Dinameo/wireless_audience_response_system/NRF52840_Quiz_Remote_BOM.xlsx

Sheet: Tổng quan
Số bo PCB cần làm | 1 | Hao hụt mặc định | 0%
Footprint trên PCB |  | 32
Linh kiện theo PCB / bo |  | 28
Số nhóm linh kiện |  | 9
Lỗ M3 (không phải linh kiện mua) |  | 4
Dòng BOM PCB chưa nhập đơn giá |  | 9
Dòng vật tư thêm bắt buộc chưa có giá |  | 1
Dự toán chi phí linh kiện / toàn bộ PCB |  | CHƯA ĐỦ GIÁ
Dự toán đầy đủ (PCB + vật tư có chọn mua) |  | CHƯA ĐỦ GIÁ
Phạm vi
BOM_PCB: 9 nhóm / 28 vị trí linh kiện đúng theo 2 file KiCad.
VAT_TU_THEM: module nRF52840, đặt gia công PCB, cọc/chân header và bộ vít nếu sử dụng.
CHI_TIET_PCB: đối chiếu đủ 32 footprint, gồm 4 lỗ M3 chỉ thuộc PCB.
Các ô chữ xanh là ô được phép điền: số PCB, hao hụt, giá, mã SKU, nhà bán và tùy chọn mua.
Nhập đơn giá thực tế (VND) trong BOM_PCB và VAT_TU_THEM để tính chi phí; không tự đặt giá tham khảo.
Chỉ mua pin CR2032-HFN có chân hàn đúng footprint, trừ khi đổi thiết kế BT1.

Sheet: BOM PCB
BOM LINH KIỆN GẮN TRÊN PCB
28 vị trí linh kiện điện tử, 9 nhóm vật tư. Giá trị & footprint theo project, giá/SKU là ô nhập tay.
STT | Reference | Tên linh kiện | Giá trị / model | Footprint trong PCB | Mặt PCB | SL / 1 bo | Số bo | Dự phòng % | SL cần mua | ĐVT | Đơn giá (VND) | Thành tiền (VND) | Mã đặt hàng / MPN | Nhà cung cấp | URL sản phẩm | Trạng thái | Ghi chú / điều cần xác nhận
1 | R1, R2, R3, R4, R5 | Điện trở chân cắm | 10 kΩ | Resistor_THT:R_Axial_DIN0207_L6.3mm_D2.5mm_P7.62mm_Horizontal | Mặt trước (F.Cu) | 5 | 1 | 0% | 5 | cái |  |  |  |  |  | CHƯA CÓ SKU | 1/4W thông dụng; thân gần 6,3×2,5 mm; bước chân 7,62 mm. Dung sai và hãng chưa được chỉ định. Cần chốt dung sai/nhà cung cấp.
2 | R6, R7, R8 | Điện trở hạn dòng LED | 330 Ω | Resistor_THT:R_Axial_DIN0207_L6.3mm_D2.5mm_P7.62mm_Horizontal | Mặt trước (F.Cu) | 3 | 1 | 0% | 3 | cái |  |  |  |  |  | CHƯA CÓ SKU | 1/4W thông dụng; thân gần 6,3×2,5 mm; bước chân 7,62 mm. Kiểm tra dòng LED theo màu/điện áp thực tế.
3 | C1, C2 | Tụ phân cực chân cắm | 10 µF | Capacitor_THT:CP_Radial_D4.0mm_P2.00mm | Mặt trước (F.Cu) | 2 | 1 | 0% | 2 | cái |  |  |  |  |  | CẦN XÁC NHẬN | D4,0 mm, P2,0 mm; điện áp định mức/chều cao chưa xác định trong schematic. Ưu tiên điện áp định mức phù hợp và kiểm tra cực tính.
4 | C3, C4, C5, C6, C7 | Tụ phân cực chân cắm | 1 µF | Capacitor_THT:CP_Radial_D5.0mm_P2.00mm | Mặt trước (F.Cu) | 5 | 1 | 0% | 5 | cái |  |  |  |  |  | CẦN XÁC NHẬN | D5,0 mm, P2,0 mm; điện áp định mức/chều cao chưa xác định trong schematic. Tụ phân cực trong mạch nút nhấn: phải kiểm tra điện áp hai đầu và chiều lắp.
5 | D1, D2, D3 | LED chân cắm 5 mm | LED D5.0 | LED_THT:LED_D5.0mm | Mặt trước (F.Cu) | 3 | 1 | 0% | 3 | cái |  |  |  |  |  | CẦN XÁC NHẬN | Màu sắc, Vf, If và mã linh kiện chưa được khai báo. Chốt màu LED và hướng A/K theo ký hiệu PCB.
6 | SW1, SW2, SW3, SW4, SW5, SW7 | Nút nhấn THT 6×6 mm | Tactile, H4.3 | Button_Switch_THT:SW_PUSH_6mm_H4.3mm | Mặt trước (F.Cu) | 6 | 1 | 0% | 6 | cái |  |  |  |  |  | CẦN XÁC NHẬN | Nút nhấn 4 chân, chiều cao 4,3 mm theo tên footprint; xác nhận vị trí 4 chân. SW1-4: A-D; SW5: SUBMIT; SW7: RESET.
7 | SW6 | Công tắc gạt SPDT | SS12D10 | SW_SS12D10_SPDT:SS12D10_SPDT_v1 | Mặt trước (F.Cu) | 1 | 1 | 0% | 1 | cái |  |  |  |  |  | CẦN XÁC NHẬN | Footprint tùy biến v1; 3 chân tại x=-4,7 / 0 / +4,7 mm. BẮT BUỘC đo chân switch thực mua khớp footprint tùy biến.
8 | J1, J2 | Socket cái thẳng 1×13 | 2.54 mm, 13P | Connector_PinSocket_2.54mm:PinSocket_1x13_P2.54mm_Vertical | Mặt sau (B.Cu) | 2 | 1 | 0% | 2 | cái |  |  |  |  |  | CẦN XÁC NHẬN | Loại xuyên lỗ chân thẳng, 13 chân/hàng; cả hai đang ở B.Cu (mặt dưới). Kiểm tra module nRF52840 2×13 và hướng cắm; mua 2 thanh 13P.
9 | BT1 | Pin CR2032 có chân hàn | CR2032-HFN | Battery:Battery_Panasonic_CR2032-HFN_Horizontal_CircularHoles | Mặt trước (F.Cu) | 1 | 1 | 0% | 1 | cái |  |  |  |  |  | CẦN XÁC NHẬN | Footprint Panasonic CR2032-HFN nằm ngang, kiểu pin hàn trực tiếp (không phải đế pin tháo rời). Pin sơ cấp 3 V: KHÔNG sạc. Nếu muốn dùng đế pin thì phải sửa footprint PCB.
 |  | TỔNG LINH KIỆN GẮN PCB |  |  |  | 28 |  |  | 28 |  |  | 0 ₫

Sheet: Vật tư thêm
VẬT TƯ BỔ SUNG & PHỤ KIỆN LẮP RÁP
Không phải tất cả đều xuất hiện trong Schematic. Cột MUA? cho phép chỉ tính vật tư thật sự cần.
STT | Loại | Tên vật tư | Thông số cần mua / chọn | SL / 1 bo | Số bo | MUA? | SL cần mua | Đơn giá (VND) | Thành tiền (VND) | Nhà cung cấp | URL sản phẩm | Ghi chú mua hàng
2 | Bắt buộc | Bo mạch PCB gia công | FR-4 2 lớp, dày 1,6 mm; theo Gerber cuối cùng | 1 | 1 | Có | 1 |  |  |  |  | Chi phí sản xuất PCB, không phải linh kiện điện tử; thông số board thickness trong file PCB là 1,6 mm.
3 | Tùy kiện | Thanh header đực 1×13, P2.54 | 2 thanh 13 chân; chỉ cần nếu module nRF52840 chưa có chân hàn sẵn | 2 | 1 | Không | 0 |  |  |  |  | Không mua trùng nếu module đã gắn pin đực.
4 | Tùy kiện | Vít M3 | Bộ vít M3 theo chiều dày vỏ/spacer thực tế | 4 | 1 | Không | 0 |  |  |  |  | Lắp vào H1-H4, lỗ khoan 3,2 mm; cần chọn chiều dài thực tế.
5 | Tùy kiện | Đai ốc M3 | Đai ốc M3 (nếu không có ren âm / insert) | 4 | 1 | Không | 0 |  |  |  |  | Cân nhắc cơ cấu bắt vào vỏ.
6 | Tùy kiện | Long đền M3 | Đệm M3 nếu cần tránh tác động lên PCB | 4 | 1 | Không | 0 |  |  |  |  | Kiểm tra đường kính ngoài đệm không chạm đường đồng/linh kiện.
7 | Tùy kiện | Spacer M3 | Trụ cách M3, chiều cao theo vỏ/mặt bo | 4 | 1 | Không | 0 |  |  |  |  | Không chọn chiều cao cho đến khi có thiết kế vỏ.
8 | Tùy kiện | Vỏ / in 3D | Vỏ bảo vệ remote nRF52840, thiết kế theo kích thước PCB | 1 | 1 | Không | 0 |  |  |  |  | Không có bản vẽ cơ khí vỏ trong dự án KiCad hiện tại.
 |  | TỔNG VẬT TƯ CHỌN MUA |  |  |  |  | 1 |  | 0 ₫

Sheet: Chi tiết PCB
DANH SÁCH 32 FOOTPRINT - ĐỐI CHIẾU
Nguồn dữ liệu: file .kicad_pcb đối chiếu .kicad_sch. H1-H4: board-only, không đếm làm linh kiện mua.
Reference | Giá trị (Sch) | Giá trị (PCB) | KiCad symbol | Footprint (trong PCB) | Pads | Mặt PCB | Có trong Schematic? | Là linh kiện BOM? | Giá trị / FP trùng Sch? | Ghi chú
BT1 | Battery_Cell | Battery_Cell | Device:Battery_Cell | Battery:Battery_Panasonic_CR2032-HFN_Horizontal_CircularHoles | 2 | F.Cu | Có | Có | Khớp | CR2032-HFN hàn trực tiếp, không phải đế pin.
C1 | 10uF | 10uF | Device:C_Polarized | Capacitor_THT:CP_Radial_D4.0mm_P2.00mm | 2 | F.Cu | Có | Có | Khớp
C2 | 10uF | 10uF | Device:C_Polarized | Capacitor_THT:CP_Radial_D4.0mm_P2.00mm | 2 | F.Cu | Có | Có | Khớp
C3 | 1uF | 1uF | Device:C_Polarized | Capacitor_THT:CP_Radial_D5.0mm_P2.00mm | 2 | F.Cu | Có | Có | Khớp
C4 | 1uF | 1uF | Device:C_Polarized | Capacitor_THT:CP_Radial_D5.0mm_P2.00mm | 2 | F.Cu | Có | Có | Khớp
C5 | 1uF | 1uF | Device:C_Polarized | Capacitor_THT:CP_Radial_D5.0mm_P2.00mm | 2 | F.Cu | Có | Có | Khớp
C6 | 1uF | 1uF | Device:C_Polarized | Capacitor_THT:CP_Radial_D5.0mm_P2.00mm | 2 | F.Cu | Có | Có | Khớp
C7 | 1uF | 1uF | Device:C_Polarized | Capacitor_THT:CP_Radial_D5.0mm_P2.00mm | 2 | F.Cu | Có | Có | Khớp
D1 | LED | LED | Device:LED | LED_THT:LED_D5.0mm | 2 | F.Cu | Có | Có | Khớp
D2 | LED | LED | Device:LED | LED_THT:LED_D5.0mm | 2 | F.Cu | Có | Có | Khớp
D3 | LED | LED | Device:LED | LED_THT:LED_D5.0mm | 2 | F.Cu | Có | Có | Khớp
H1 |  | MountingHole_3.2mm_M3 | (PCB only) | MountingHole:MountingHole_3.2mm_M3 | 1 | F.Cu | Không | Không | Chỉ có trên PCB | Lỗ cơ khí 3,2 mm cho vít M3; không cần mua footprint. Board-only / exclude_from_bom.
H2 |  | MountingHole_3.2mm_M3 | (PCB only) | MountingHole:MountingHole_3.2mm_M3 | 1 | F.Cu | Không | Không | Chỉ có trên PCB | Lỗ cơ khí 3,2 mm cho vít M3; không cần mua footprint. Board-only / exclude_from_bom.
H3 |  | MountingHole_3.2mm_M3 | (PCB only) | MountingHole:MountingHole_3.2mm_M3 | 1 | F.Cu | Không | Không | Chỉ có trên PCB | Lỗ cơ khí 3,2 mm cho vít M3; không cần mua footprint. Board-only / exclude_from_bom.
H4 |  | MountingHole_3.2mm_M3 | (PCB only) | MountingHole:MountingHole_3.2mm_M3 | 1 | F.Cu | Không | Không | Chỉ có trên PCB | Lỗ cơ khí 3,2 mm cho vít M3; không cần mua footprint. Board-only / exclude_from_bom.
J1 | NRF_LEFT | NRF_LEFT | Connector:Conn_01x13_Socket | Connector_PinSocket_2.54mm:PinSocket_1x13_P2.54mm_Vertical | 13 | B.Cu | Có | Có | Khớp | Socket được đặt ở mặt B.Cu; kiểm tra hướng lắp.
J2 | NRF_RIGHT | NRF_RIGHT | Connector:Conn_01x13_Socket | Connector_PinSocket_2.54mm:PinSocket_1x13_P2.54mm_Vertical | 13 | B.Cu | Có | Có | Khớp | Socket được đặt ở mặt B.Cu; kiểm tra hướng lắp.
R1 | 10k | 10k | Device:R | Resistor_THT:R_Axial_DIN0207_L6.3mm_D2.5mm_P7.62mm_Horizontal | 2 | F.Cu | Có | Có | Khớp
R2 | 10k | 10k | Device:R | Resistor_THT:R_Axial_DIN0207_L6.3mm_D2.5mm_P7.62mm_Horizontal | 2 | F.Cu | Có | Có | Khớp
R3 | 10k | 10k | Device:R | Resistor_THT:R_Axial_DIN0207_L6.3mm_D2.5mm_P7.62mm_Horizontal | 2 | F.Cu | Có | Có | Khớp
R4 | 10k | 10k | Device:R | Resistor_THT:R_Axial_DIN0207_L6.3mm_D2.5mm_P7.62mm_Horizontal | 2 | F.Cu | Có | Có | Khớp
R5 | 10k | 10k | Device:R | Resistor_THT:R_Axial_DIN0207_L6.3mm_D2.5mm_P7.62mm_Horizontal | 2 | F.Cu | Có | Có | Khớp
R6 | 330 | 330 | Device:R | Resistor_THT:R_Axial_DIN0207_L6.3mm_D2.5mm_P7.62mm_Horizontal | 2 | F.Cu | Có | Có | Khớp
R7 | 330 | 330 | Device:R | Resistor_THT:R_Axial_DIN0207_L6.3mm_D2.5mm_P7.62mm_Horizontal | 2 | F.Cu | Có | Có | Khớp
R8 | 330 | 330 | Device:R | Resistor_THT:R_Axial_DIN0207_L6.3mm_D2.5mm_P7.62mm_Horizontal | 2 | F.Cu | Có | Có | Khớp
SW1 | ANSWER_A | ANSWER_A | Switch:SW_Push | Button_Switch_THT:SW_PUSH_6mm_H4.3mm | 4 | F.Cu | Có | Có | Khớp
SW2 | ANSWER_B | ANSWER_B | Switch:SW_Push | Button_Switch_THT:SW_PUSH_6mm_H4.3mm | 4 | F.Cu | Có | Có | Khớp
SW3 | ANSWER_C | ANSWER_C | Switch:SW_Push | Button_Switch_THT:SW_PUSH_6mm_H4.3mm | 4 | F.Cu | Có | Có | Khớp
SW4 | ANSWER_D | ANSWER_D | Switch:SW_Push | Button_Switch_THT:SW_PUSH_6mm_H4.3mm | 4 | F.Cu | Có | Có | Khớp
SW5 | SUBMIT | SUBMIT | Switch:SW_Push | Button_Switch_THT:SW_PUSH_6mm_H4.3mm | 4 | F.Cu | Có | Có | Khớp
SW6 | POWER | POWER | Switch:SW_SPST | SW_SS12D10_SPDT:SS12D10_SPDT_v1 | 3 | F.Cu | Có | Có | Khớp | Công tắc footprint tùy biến; đo kích thước thật.
SW7 | RESET | RESET | Switch:SW_Push | Button_Switch_THT:SW_PUSH_6mm_H4.3mm | 4 | F.Cu | Có | Có | Khớp

Sheet: Lưu ý
CHECKLIST TRƯỚC KHI ĐẶT MUA
Những rủi ro có thể ảnh hưởng đến việc mua đúng hàng và lắp ráp được PCB.
Hạng mục | Thông tin phát hiện | Việc phải kiểm tra / thao tác | Mức độ | Nguồn
NGUỒN / PIN | BT1 đang dùng Battery:Battery_Panasonic_CR2032-HFN_Horizontal_CircularHoles. | Phải dùng pin CR2032 có tab chân hàn dạng HFN đúng bước chân/không gian; nếu thay bằng đế pin CR2032 thông thường cần sửa footprint và layout. | Rất quan trọng | https://gitlab.com/kicad/libraries/kicad-footprints/-/blob/master/Battery.pretty/Battery_Panasonic_CR2032-HFN_Horizontal_CircularHoles.kicad_mod
AN TOÀN PIN | CR2032 là pin lithium sơ cấp danh định 3 V, không thể sạc. | Kiểm tra đường mạch module và chân cấp nguồn thực tế; tuyệt đối không nối đường sạc vào pin CR2032. | Rất quan trọng | https://energy.panasonic.com/dam/master/pdf/en/datasheet/lithium/CR2032_Datasheet_EN_240701.pdf
MÓC NỐI / MODULE | J1 và J2 là hai socket 13 chân 2.54 mm, đặt trên B.Cu. | Đối chiếu sơ đồ chân, chiều rộng 2 hàng và mặt lắp nRF52840 SuperMini; chân đực module phải tương thích socket cái mặt dưới. | Rất quan trọng | https://kicad.github.io/footprints/Connector_PinSocket_2.54mm.html
CÔNG TẮC | SW6 có footprint tùy biến SW_SS12D10_SPDT:SS12D10_SPDT_v1. | Theo file .kicad_mod: 3 tâm chân ở x = -4,7; 0; +4,7 mm, 1mm drill. Không mua switch chỉ dựa tên SS12D10. | Rất quan trọng | Nguồn nội bộ: SW_SS12D10_SPDT.pretty/SS12D10_SPDT_v1.kicad_mod
TỤ PHÂN CỰC | C1-C7 đều dùng symbol Device:C_Polarized. | C1-C2: 10 µF, D4mm P2mm; C3-C7: 1 µF, D5mm P2mm. Chưa có điện áp định mức, chiều cao hay MPN. | Cần kiểm tra | Nguồn nội bộ: .kicad_sch và .kicad_pcb
TỤ CHỐNG DỘI | C3-C7 dùng tụ phân cực tại các mạch nút nhấn theo giá trị 1 µF. | Kiểm tra cực tính theo mức áp từng chân trong tất cả trạng thái, phù hợp thời gian debounce; tụ không phân cực có thể cần footprint khác. | Cần kiểm tra | Nguồn nội bộ: .kicad_sch
LED | D1-D3 chỉ khai báo giá trị LED, không ghi màu hoặc mã. | Chọn LED 5 mm cùng chân THT; xác nhận màu/độ sáng/Vf/If để kiểm tra điện trở 330 Ω. | Cần kiểm tra | Nguồn nội bộ: .kicad_sch
ĐIỆN TRỞ | R1-R5: 10 kΩ; R6-R8: 330 Ω; footprint DIN0207 L6.3×D2.5 P7.62. | Chọn linh kiện 1/4 W hoặc tương đương có kích thước thân/chân tương thích. Trị số chịu sai số chưa chỉ định. | Cần kiểm tra | Nguồn nội bộ: .kicad_pcb
NÚT NHẤN | SW1-SW5 và SW7 có footprint SW_PUSH_6mm_H4.3mm. | Mua nút nhấn THT 6×6 mm đúng vị trí 4 chân; kiểm tra chiều cao lộ ra khỏi vỏ. | Cần kiểm tra | Nguồn nội bộ: .kicad_pcb
LỖ CƠ KHÍ | H1-H4 là lỗ M3, pad 3,2 mm, thuộc tính board_only và exclude_from_bom. | Không mua một linh kiện tên H1. Mua ốc M3 và spacer chỉ khi cấu trúc vỏ yêu cầu; kiểm tra vùng trống quanh đầu vít. | Thông tin | Nguồn nội bộ: .kicad_pcb
BOM & DỮ LIỆU | Không có MPN/SKU, supplier, unit price và datasheet linh kiện cụ thể trong Schematic. | Vì thế file này để trống các trường mua hàng để tránh giả định sai. Sau khi chọn mẫu thật, lưu datasheet/link vào Excel. | Cần bổ sung | Nguồn nội bộ: .kicad_sch
DRC / ERC | BOM không chứng minh PCB đúng điện hoặc phù hợp để chế tạo. | Kiểm tra ERC, DRC, polarity, 3D cơ khí, output Gerber/drill; BOM chỉ xác minh số lượng và footprint. | Thông tin | Nguồn nội bộ: .kicad_pcb/.kicad_sch

Sheet: Nguồn dữ liệu
NGUỒN & PHƯƠNG PHÁP TRÍCH XUẤT
Thông tin | Giá trị / mô tả
Tên dự án | NRF52840_Quiz_Remote
Nguồn schematic | NRF52840_Quiz_Remote/NRF52840_Quiz_Remote.kicad_sch
Nguồn PCB | NRF52840_Quiz_Remote/NRF52840_Quiz_Remote.kicad_pcb
SHA256 schematic | 02c77d5245ab06772fbb29b13a0cc0347ea4944395376ec3a9d2d5b3516fb469
SHA256 PCB | bcae5cba2324009f77dd3607b17fb2695f55706239005fb1716ed6d1a14543d0
KiCad PCB version | 10.0 (ghi trong file PCB)
BOM PCB | Nhóm theo loại, trị số và footprint; 28 linh kiện, 9 dòng nhóm
Lỗ M3 | H1-H4: board only, excluded from standard BOM; nằm tại sheet CHI_TIET_PCB
Giá, MPN, NCC | Không có trong KiCad; được để trống để cập nhật theo báo giá thực tế
Module nRF52840 | Không có một footprint U1 rời trong PCB; được ghi thêm mục vật tư để có đủ vật liệu làm sản phẩm
THAM KHẢO
KiCad: footprint CR2032-HFN | https://gitlab.com/kicad/libraries/kicad-footprints/-/blob/master/Battery.pretty/Battery_Panasonic_CR2032-HFN_Horizontal_CircularHoles.kicad_mod
Panasonic: CR2032 datasheet | https://energy.panasonic.com/dam/master/pdf/en/datasheet/lithium/CR2032_Datasheet_EN_240701.pdf
KiCad: footprint socket 2.54mm | https://kicad.github.io/footprints/Connector_PinSocket_2.54mm.html
