Dinameo/wireless_audience_response_system/Case/Submit.SLDPRT

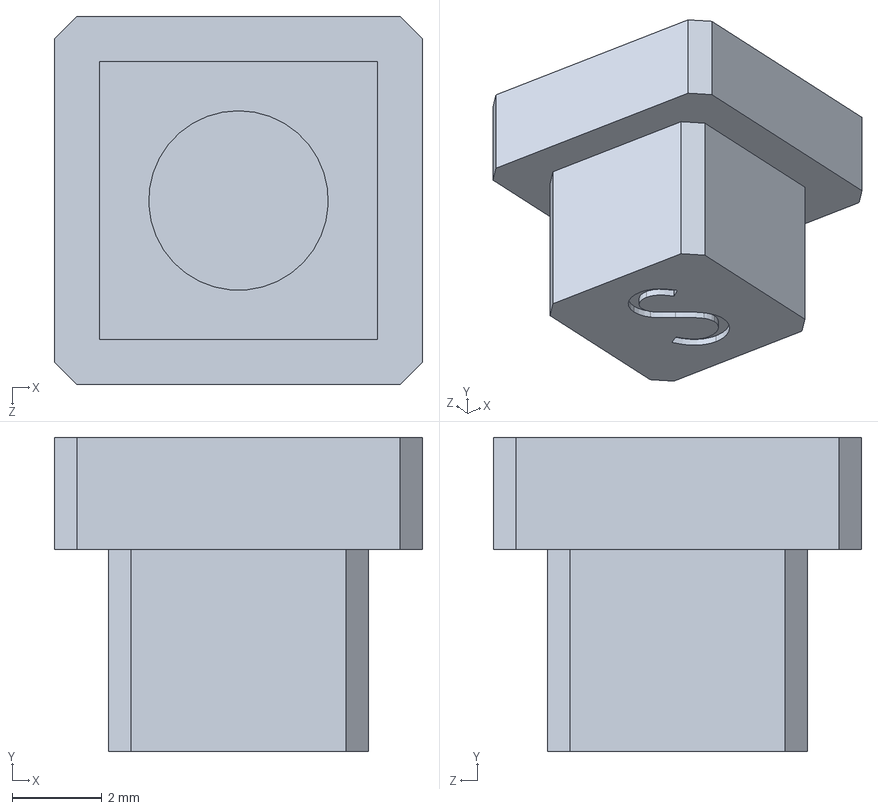
[picture p6: CAD file, 2026-10-14]
Case/Submit.SLDPRT
8.20 x 7.00 x 8.20 mm
