Dinameo/wireless_audience_response_system/Case/D_ans.SLDPRT

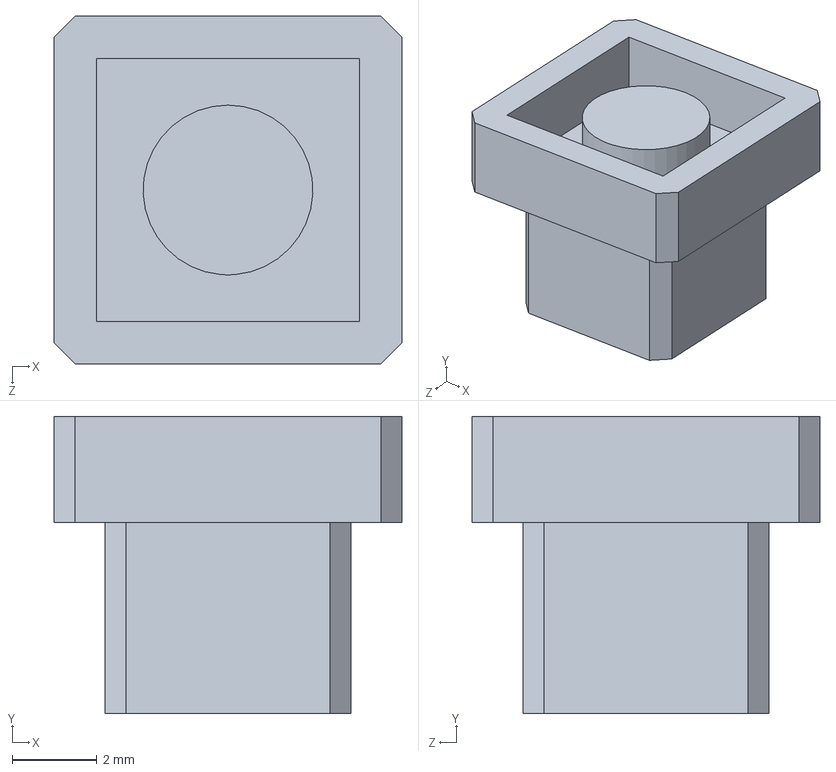
[picture p7: CAD file, 2026-10-14]
Case/D_ans.SLDPRT
8.20 x 7.00 x 8.20 mm
