Dinameo/wireless_audience_response_system/Case/Top.SLDPRT

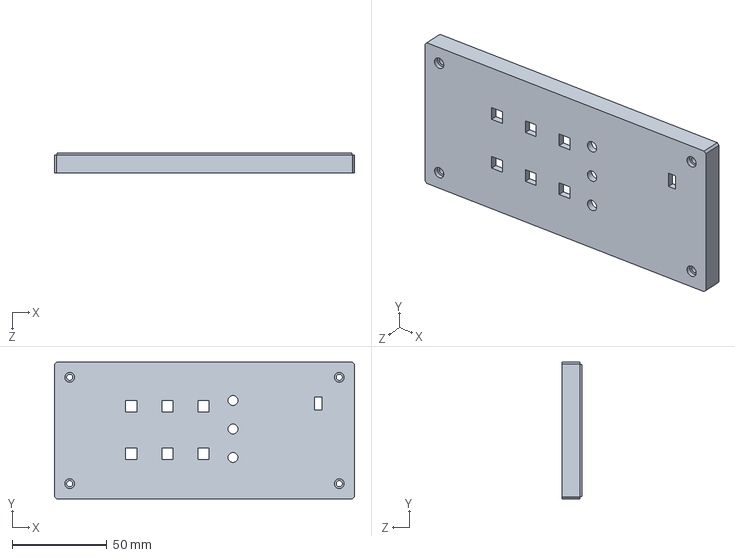
[picture p8: CAD file, 2026-10-14]
Case/Top.SLDPRT
158.0 x 72.0 x 10.5 mm
