Dinameo/wireless_audience_response_system/Case/Bottom.SLDPRT

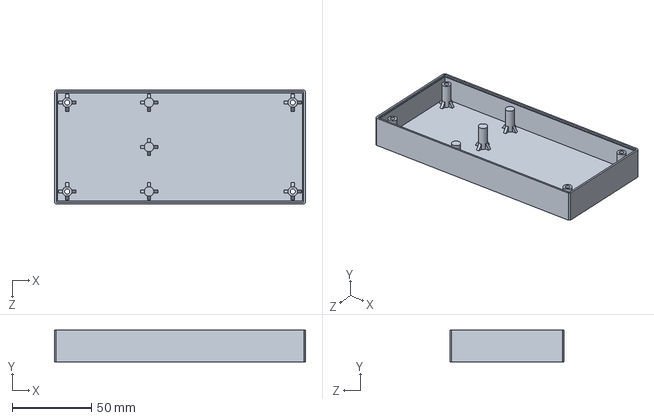
[picture p9: CAD file, 2026-10-14]
Case/Bottom.SLDPRT
158.0 x 20.0 x 72.0 mm
