Dinameo/wireless_audience_response_system/Case/Remote.SLDASM

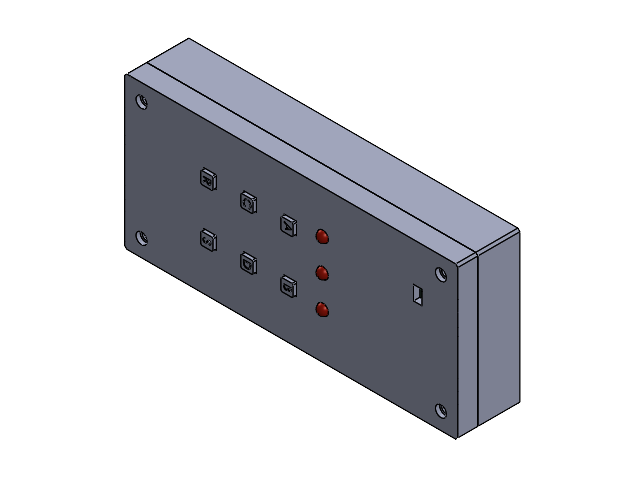
[picture p11: CAD file, 2026-10-14]
Case/Remote.SLDASM
Top
A_ans
Bottom
B_ans
C_ans
D_ans
Submit
Reset
R_Axial_DIN0207_L63mm_D25mm_P762mm_Horizontal.step x 8
LED_D5.0mm-0.step x 3
SW_PUSH_6mm_h4.3mm_1.step x 6
CP_Radial_D50mm_P200mm.step x 5
CP_Radial_D40mm_P200mm.step x 2
PinSocket_1x13_P2.54mm_Vertical-1.step x 2
NRF52840_Quiz_Remote_PCB.step
