Dinameo/wireless_audience_response_system/(list of files, cad)

Other CAD files:
Case/Reset.SLDPRT
Case/A_ans.SLDPRT
Case/B_ans.SLDPRT
Case/C_ans.SLDPRT
Case/A_ans.STL
Case/B_ans.STL
Case/Bottom.STL
Case/C_ans.STL
Case/D_ans.STL
Case/Reset.STL
Case/Submit.STL
Case/Top.STL
