Dinameo/wireless_audience_response_system/NRF52840_Quiz_Remote/NRF52840_Quiz_Remote.kicad_pcb

## KiCad design NRF52840_Quiz_Remote/NRF52840_Quiz_Remote.kicad_pcb (2026-10-14)

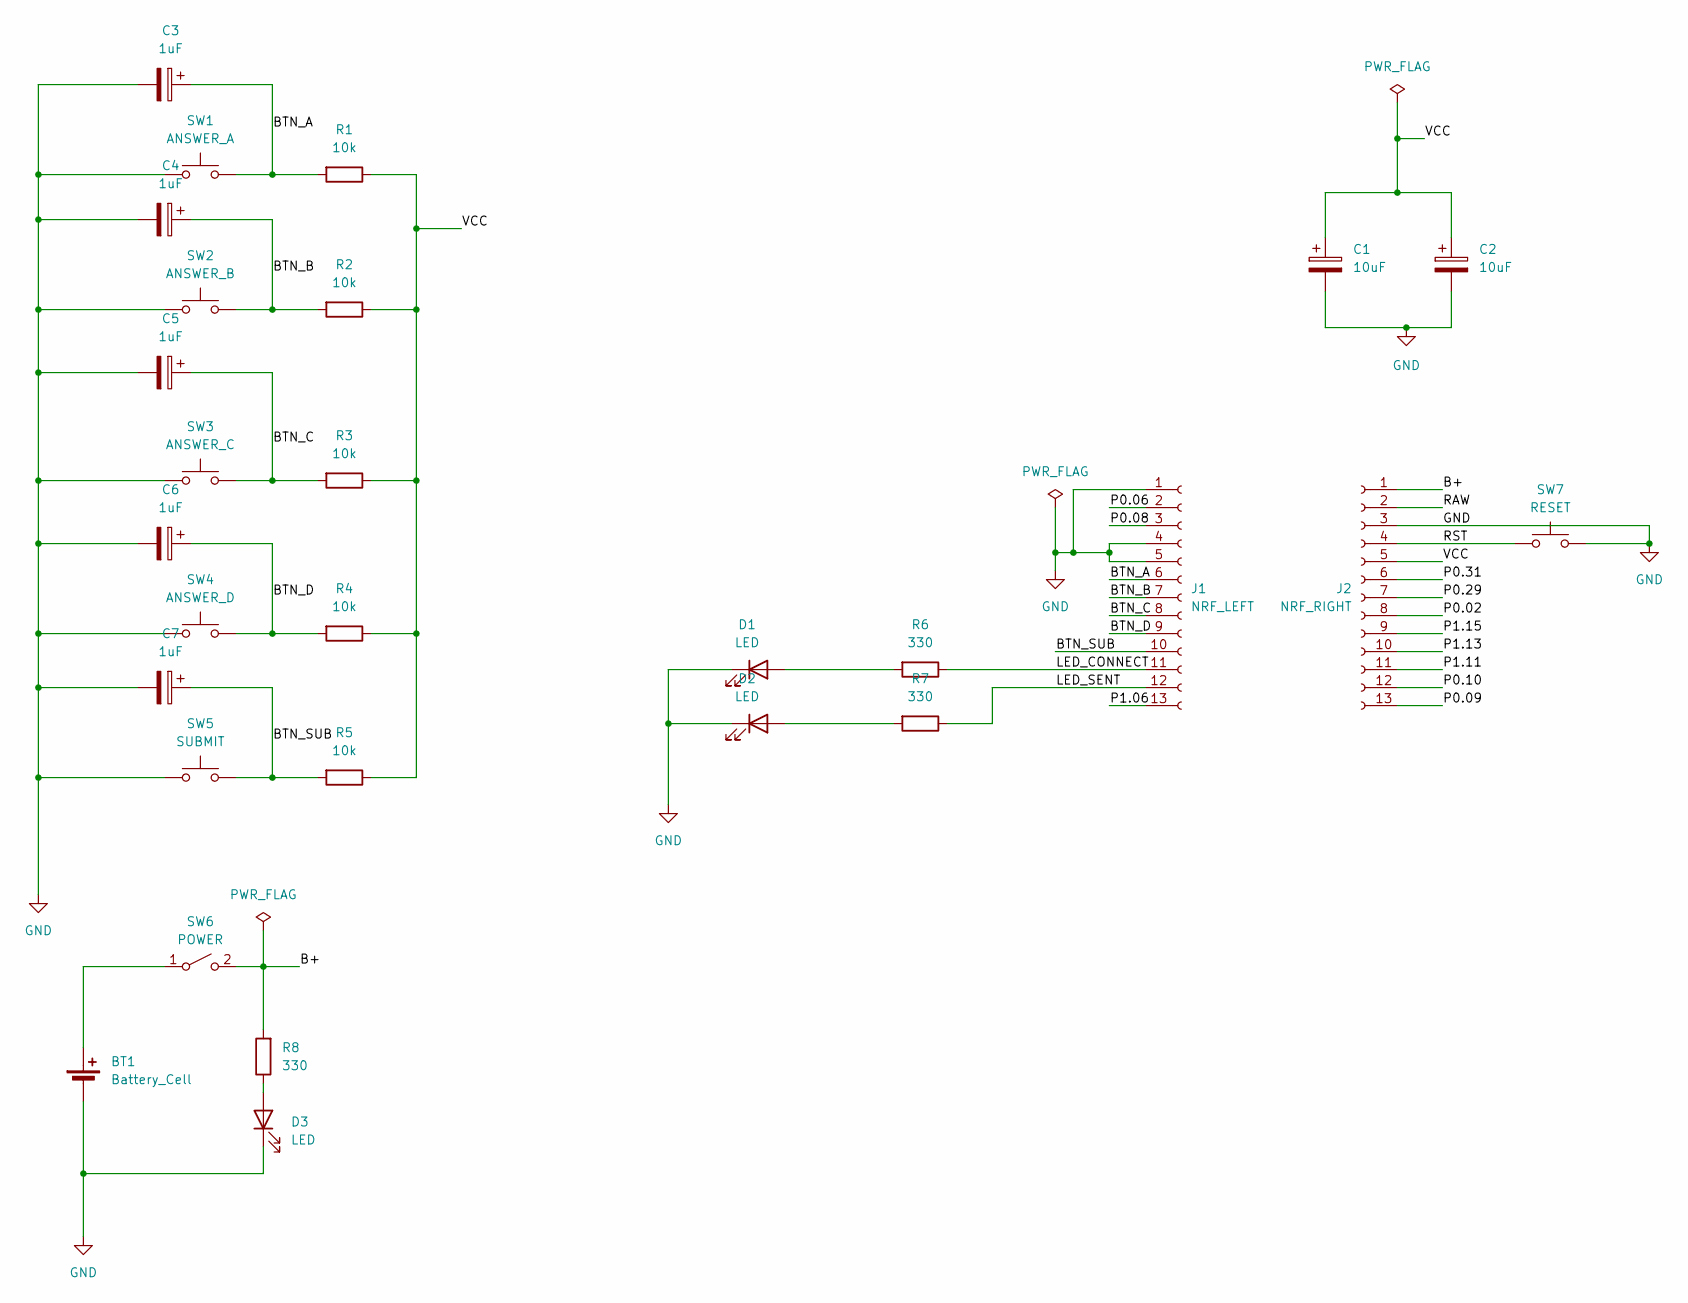
[picture p12: schematic NRF52840_Quiz_Remote.kicad_sch]

Parts:
BT1: Battery_Cell; Battery_Panasonic_CR2032-HFN_Horizontal_CircularHoles
C1, C2: 10uF; CP_Radial_D4.0mm_P2.00mm
C3, C4, C5, C6, C7: 1uF; CP_Radial_D5.0mm_P2.00mm
D1, D2, D3: LED; LED_D5.0mm
J1: NRF_LEFT; PinSocket_1x13_P2.54mm_Vertical
J2: NRF_RIGHT; PinSocket_1x13_P2.54mm_Vertical
R1, R2, R3, R4, R5: 10k; R_Axial_DIN0207_L6.3mm_D2.5mm_P7.62mm_Horizontal
R6, R7, R8: 330; R_Axial_DIN0207_L6.3mm_D2.5mm_P7.62mm_Horizontal
SW1: ANSWER_A; SW_PUSH_6mm_H4.3mm
SW2: ANSWER_B; SW_PUSH_6mm_H4.3mm
SW3: ANSWER_C; SW_PUSH_6mm_H4.3mm
SW4: ANSWER_D; SW_PUSH_6mm_H4.3mm
SW5: SUBMIT; SW_PUSH_6mm_H4.3mm
SW6: POWER; SS12D10_SPDT_v1
SW7: RESET; SW_PUSH_6mm_H4.3mm

Connections:
/B+: J2.1, R8.2, SW6.2 (B)
/BTN_A: C3.1, J1.6, R1.2, SW1.2
/BTN_B: C4.1, J1.7, R2.2, SW2.2
/BTN_C: C5.1, J1.8, R3.2, SW3.2
/BTN_D: C6.1, J1.9, R4.2, SW4.2
/BTN_SUB: C7.1, J1.10, R5.2, SW5.2
/LED_CONNECT: J1.11, R6.1
/LED_SENT: J1.12, R7.1
/P0.02: J2.8
/P0.06: J1.2
/P0.08: J1.3
/P0.09: J2.13
/P0.10: J2.12
/P0.29: J2.7
/P0.31: J2.6
/P1.06: J1.13
/P1.11: J2.11
/P1.13: J2.10
/P1.15: J2.9
/RAW: J2.2
/RST: J2.4, SW7.1
/VCC: C1.1, C2.1, J2.5, R1.1, R2.1, R3.1, R4.1, R5.1
GND: BT1.2 (-), C1.2, C2.2, C3.2, C4.2, C5.2, C6.2, C7.2, D1.1 (K), D2.1 (K), D3.1 (K), J1.1, J1.4, J1.5, J2.3, SW1.1, SW2.1, SW3.1, SW4.1, SW5.1, SW7.2
unnamed: BT1.1 (+), SW6.1 (A)
unnamed: D1.2 (A), R6.2
unnamed: D2.2 (A), R7.2
unnamed: D3.2 (A), R8.1

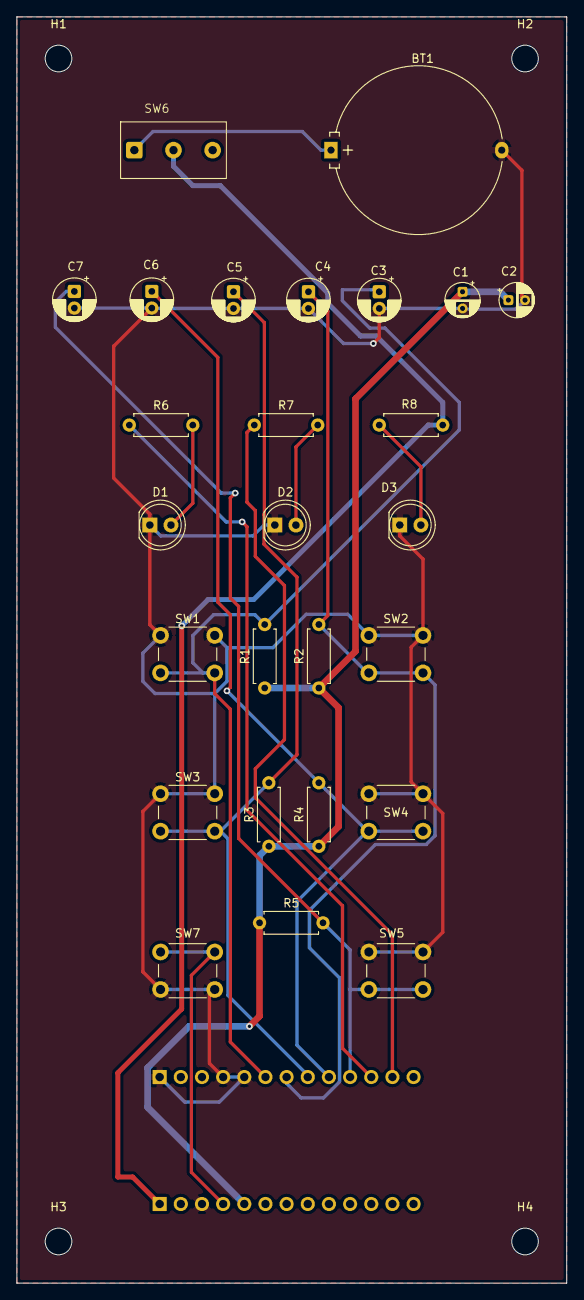
[picture p13: board NRF52840_Quiz_Remote.kicad_pcb from above]

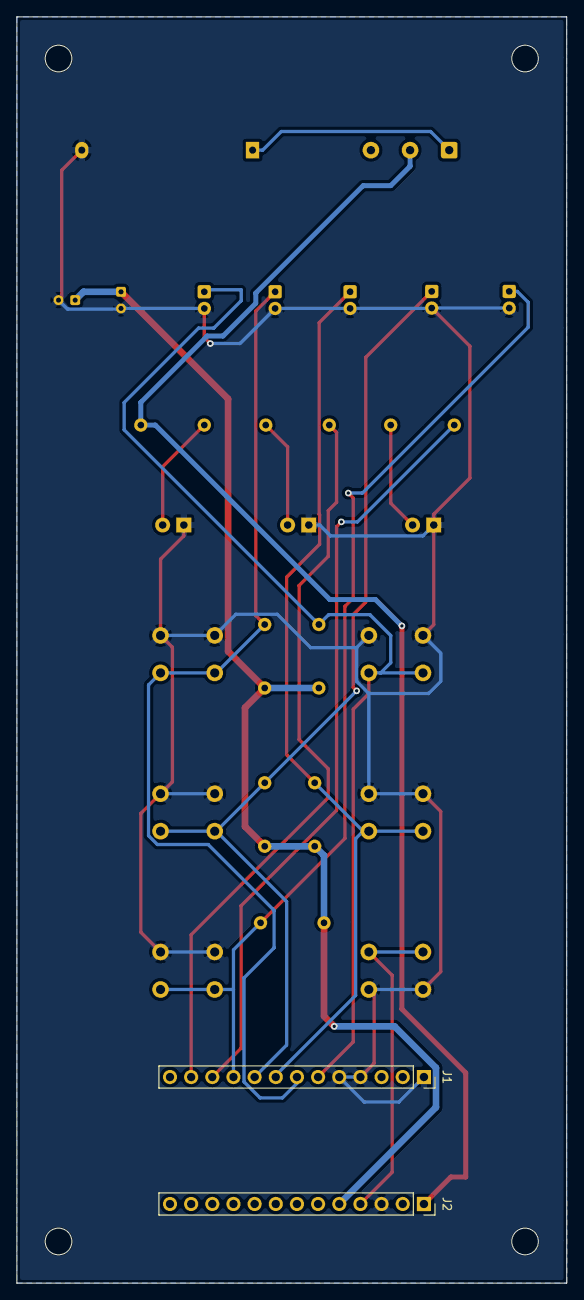
[picture p14: board NRF52840_Quiz_Remote.kicad_pcb from below]

Board: 2 copper layers, 66.0 x 152.0 mm, 32 parts (2 on the bottom side), 15 nets.

Other parts of the board:
H1, H2, H3, H4: MountingHole_3.2mm_M3
