Dinameo/wireless_audience_response_system/(commit log)

2026-10-04 Add KiCad remote project
    [NRF52840_Quiz_Remote.kicad_pcb, NRF52840_Quiz_Remote.kicad_sch]
2026-10-04 del example
    [NRF52840_Quiz_Remote.kicad_pcb]
2026-10-14 update src nrf
    [A_ans.SLDPRT, A_ans.STL, B_ans.SLDPRT, B_ans.STL, Bottom.SLDPRT, Bottom.STL, C_ans.SLDPRT, C_ans.STL]
2026-10-14 Add BOM from van branch
    [NRF52840_Quiz_Remote_BOM.xlsx]
